NaufalElyzar11/AAC-Pelipat-Pakaian/pratinjau_3d.png

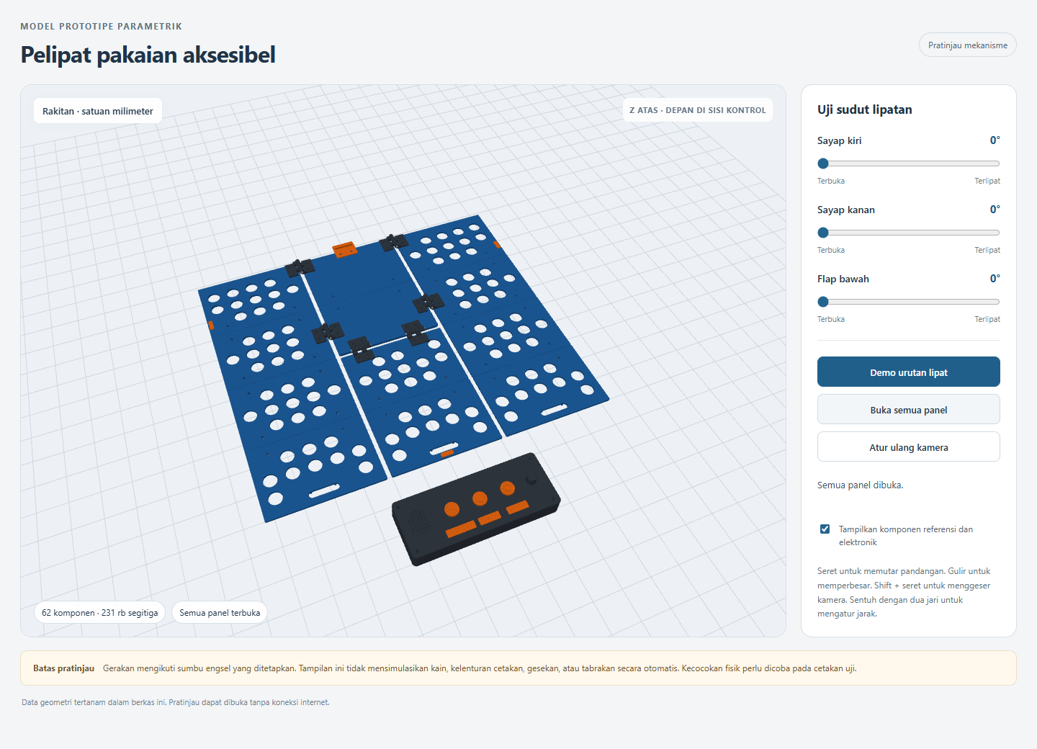
pratinjau_3d.png
