NaufalElyzar11/AAC-Pelipat-Pakaian/step/assembly_open.step

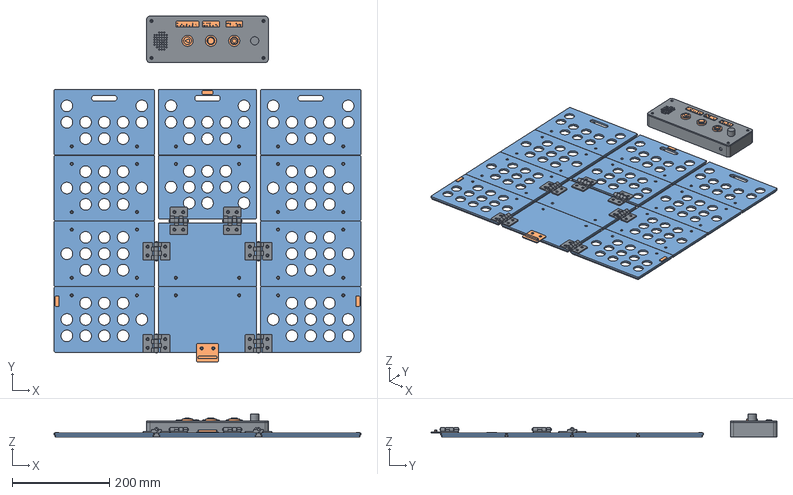
[picture p2: CAD file, 2026-10-27]
step/assembly_open.step
630.0 x 711.0 x 47.2 mm
panel_L1
panel_L2
panel_L3
panel_L4
splice_L_1_1
splice_L_1_2
splice_L_2_1
splice_L_2_2
splice_L_3_1
splice_L_3_2
panel_R1
panel_R2
panel_R3
panel_R4
splice_R_1_1
splice_R_1_2
splice_R_2_1
splice_R_2_2
splice_R_3_1
splice_R_3_2
panel_F1
panel_F2
splice_F_1_1
splice_F_1_2
panel_B1
panel_B2
splice_B_1_1
splice_B_1_2
L1_fixed
L1_moving
L1_pin
L2_fixed
L2_moving
L2_pin
R1_fixed
R1_moving
R1_pin
R2_fixed
R2_moving
R2_pin
B1_fixed
B1_moving
B1_pin
B2_fixed
B2_moving
B2_pin
collar_stop
left_index
right_index
bottom_index
control_base
control_lid
braille_kembali
braille_mulai
braille_ulang
button_reference_1
button_overlay_back
button_reference_2
button_overlay_next
button_reference_3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
