NaufalElyzar11/AAC-Pelipat-Pakaian/step/TEST_pin_bores_42_43_44_45.step

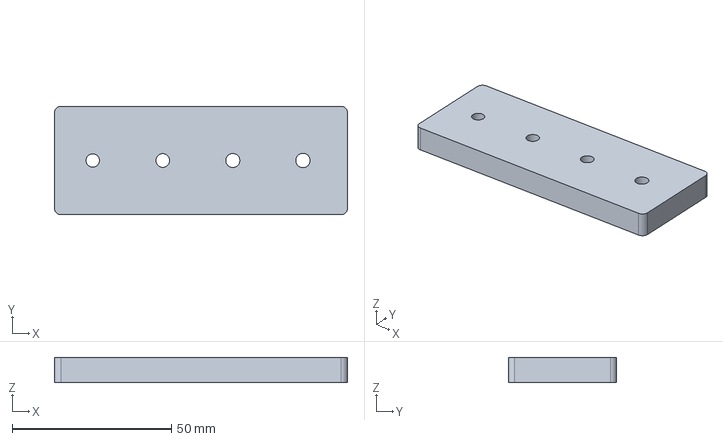
[picture p3: CAD file, 2026-10-27]
step/TEST_pin_bores_42_43_44_45.step
92.0 x 34.0 x 8.00 mm
