NaufalElyzar11/AAC-Pelipat-Pakaian/tests/TEST_hinge_panel_moving.stl

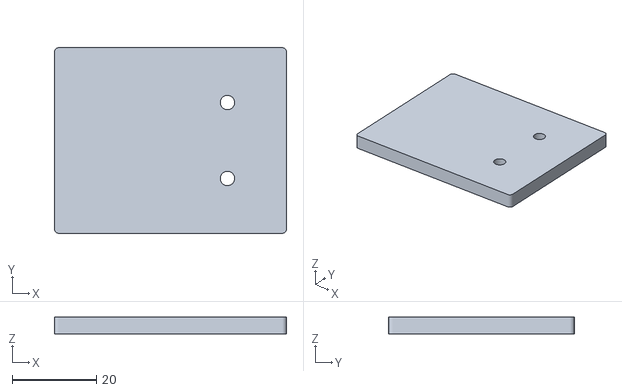
[picture p4: CAD file, 2026-10-27]
tests/TEST_hinge_panel_moving.stl
55.0 x 44.0 x 4.00
