NaufalElyzar11/AAC-Pelipat-Pakaian/step/panel_B1.step

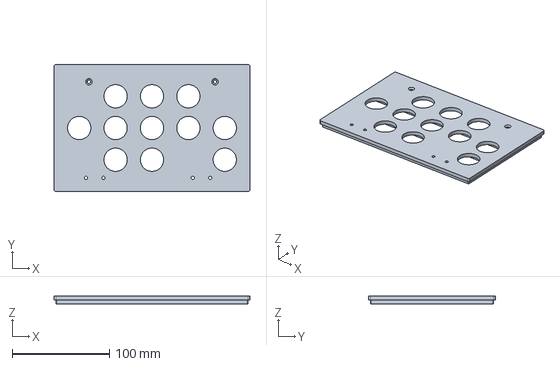
[picture p5: CAD file, 2026-10-27]
step/panel_B1.step
202.0 x 130.8 x 8.00 mm
