NaufalElyzar11/AAC-Pelipat-Pakaian/tests/TEST_splice_panel_A.stl

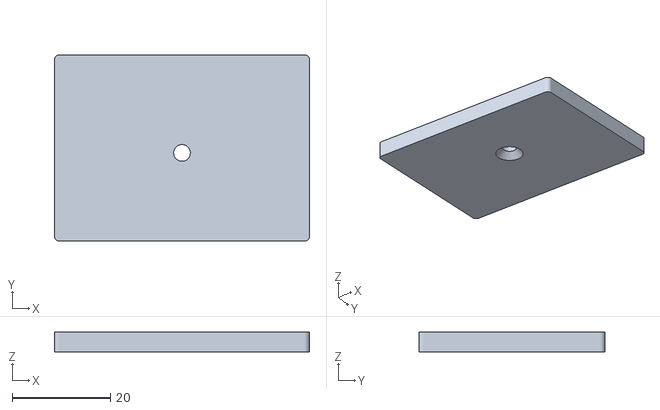
[picture p6: CAD file, 2026-10-27]
tests/TEST_splice_panel_A.stl
52.0 x 38.0 x 4.00
