NaufalElyzar11/AAC-Pelipat-Pakaian/step/splice_strap.step

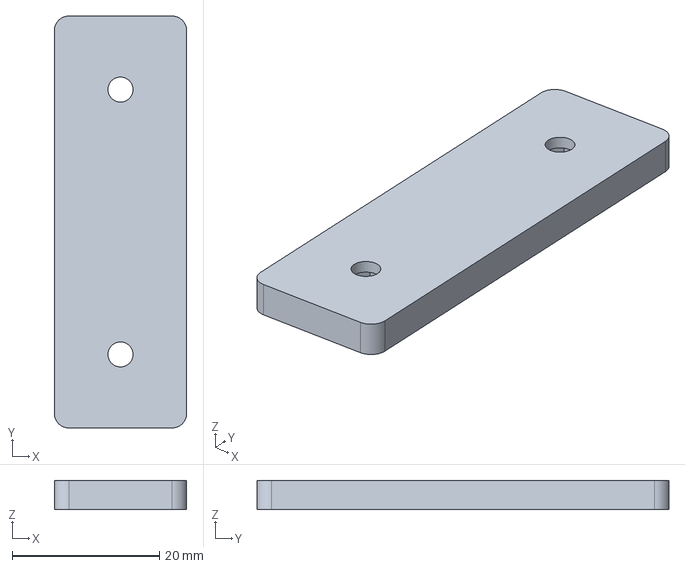
[picture p7: CAD file, 2026-10-27]
step/splice_strap.step
18.0 x 56.0 x 4.00 mm
