NaufalElyzar11/AAC-Pelipat-Pakaian/step/marker_collar.step

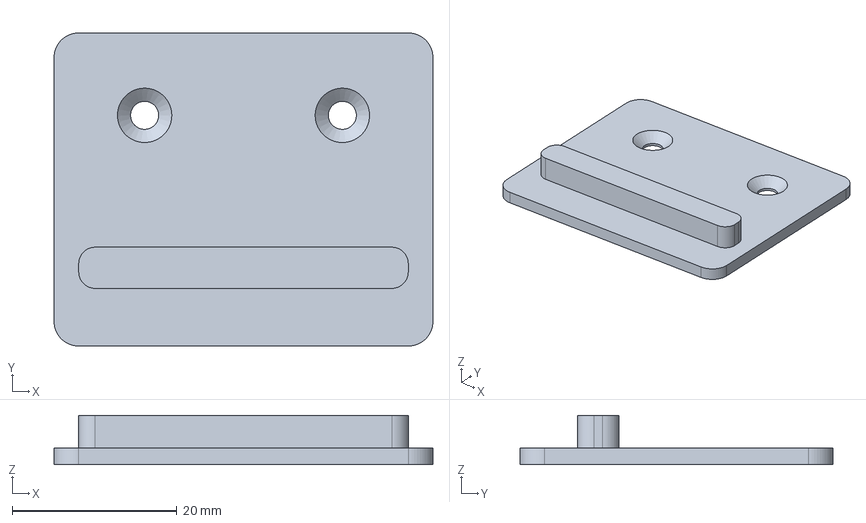
[picture p9: CAD file, 2026-10-27]
step/marker_collar.step
46.0 x 38.0 x 6.00 mm
