NaufalElyzar11/AAC-Pelipat-Pakaian/step/panel_R2.step

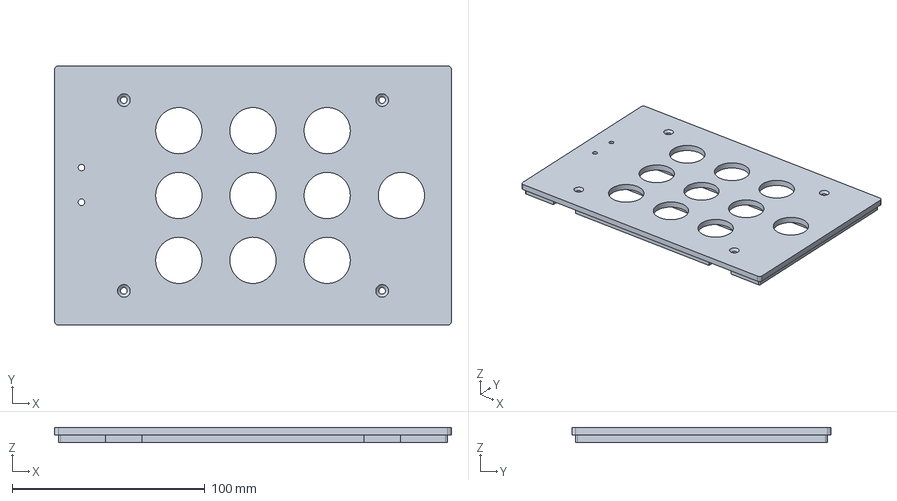
[picture p10: CAD file, 2026-10-27]
step/panel_R2.step
206.0 x 134.6 x 8.00 mm
