NaufalElyzar11/AAC-Pelipat-Pakaian/step/panel_L4.step

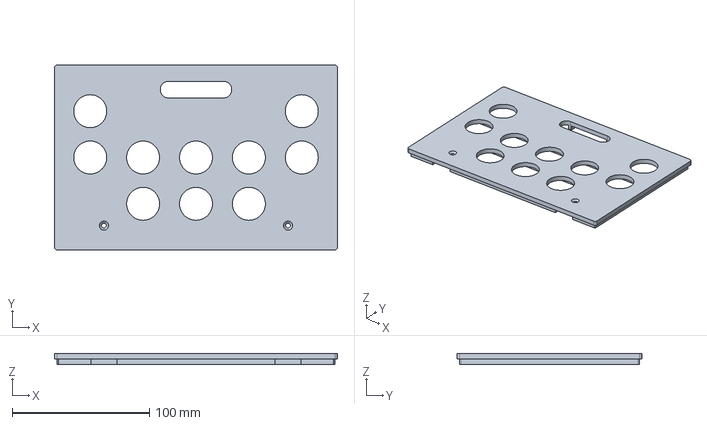
[picture p11: CAD file, 2026-10-27]
step/panel_L4.step
206.0 x 134.8 x 8.00 mm
