NaufalElyzar11/AAC-Pelipat-Pakaian/step/hinge_B.step

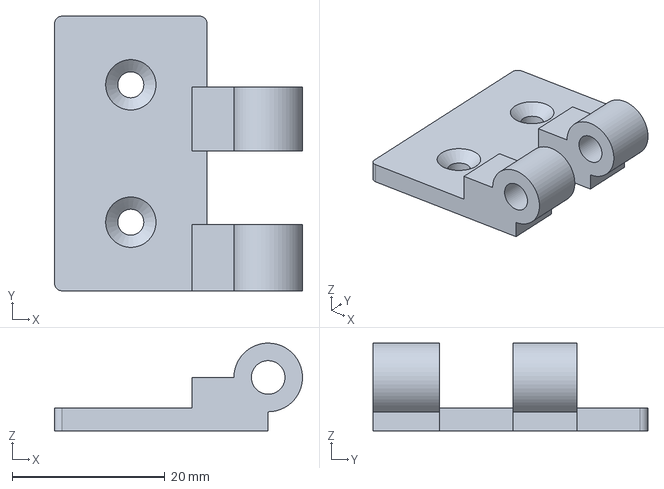
[picture p14: CAD file, 2026-10-27]
step/hinge_B.step
32.5 x 36.0 x 11.5 mm
