NaufalElyzar11/AAC-Pelipat-Pakaian/step/panel_F1.step

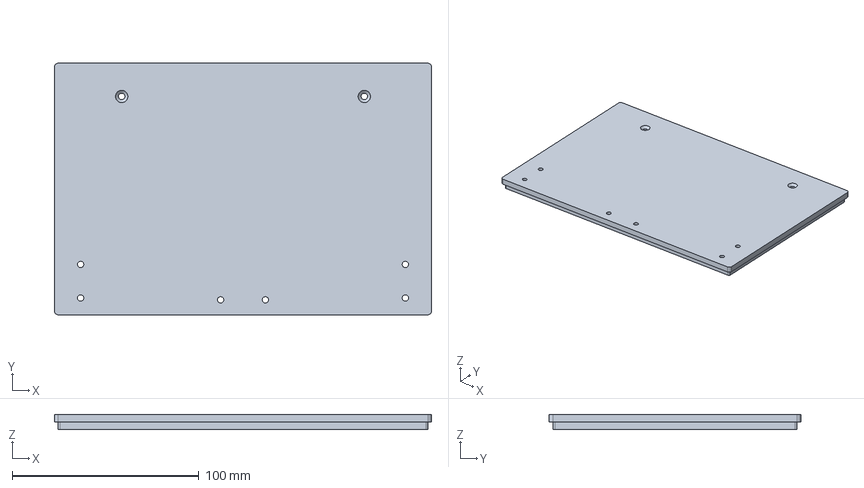
[picture p15: CAD file, 2026-10-27]
step/panel_F1.step
202.0 x 134.8 x 8.00 mm
