NaufalElyzar11/AAC-Pelipat-Pakaian/step/braille_kembali.step

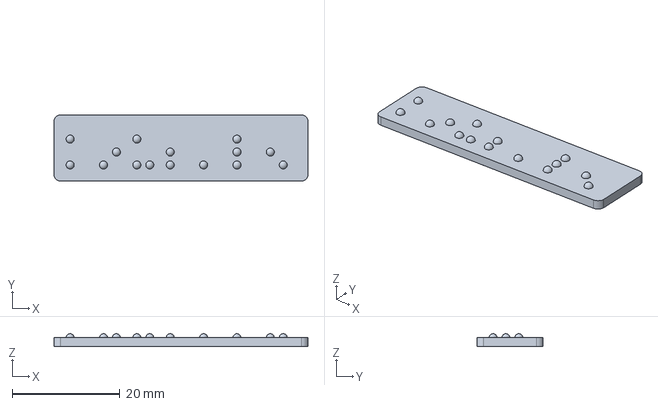
[picture p16: CAD file, 2026-10-27]
step/braille_kembali.step
47.2 x 12.3 x 2.35 mm
