NaufalElyzar11/AAC-Pelipat-Pakaian/step/button_overlay_next.step

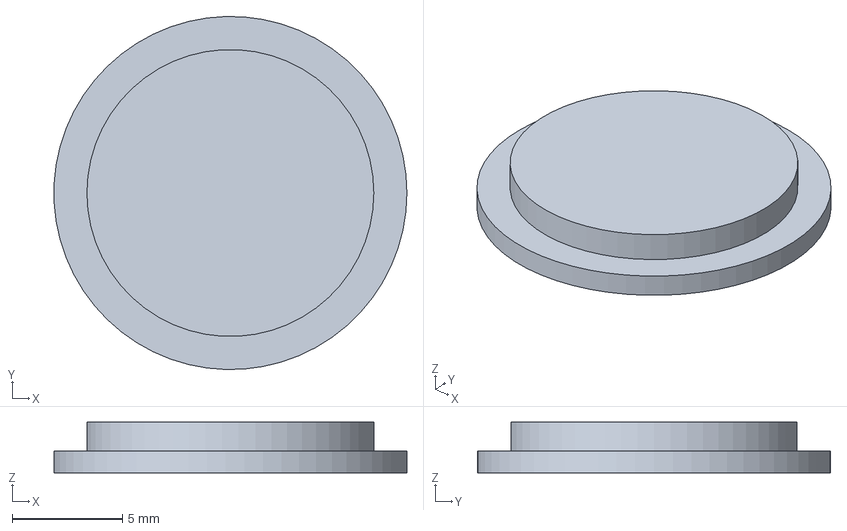
[picture p17: CAD file, 2026-10-27]
step/button_overlay_next.step
16.0 x 16.0 x 2.30 mm
