NaufalElyzar11/AAC-Pelipat-Pakaian/step/OPTION_sensor_adapter_template.step

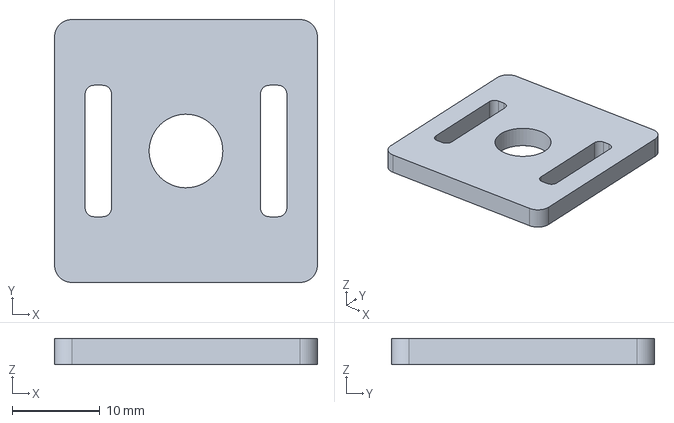
[picture p18: CAD file, 2026-10-27]
step/OPTION_sensor_adapter_template.step
30.0 x 30.0 x 3.00 mm
