NaufalElyzar11/AAC-Pelipat-Pakaian/step/control_lid.step

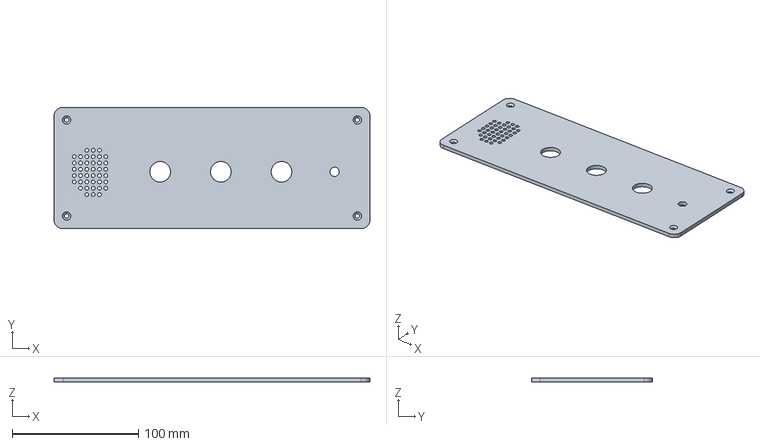
[picture p19: CAD file, 2026-10-27]
step/control_lid.step
250.0 x 96.0 x 3.20 mm
