NaufalElyzar11/AAC-Pelipat-Pakaian/step/braille_ulang.step

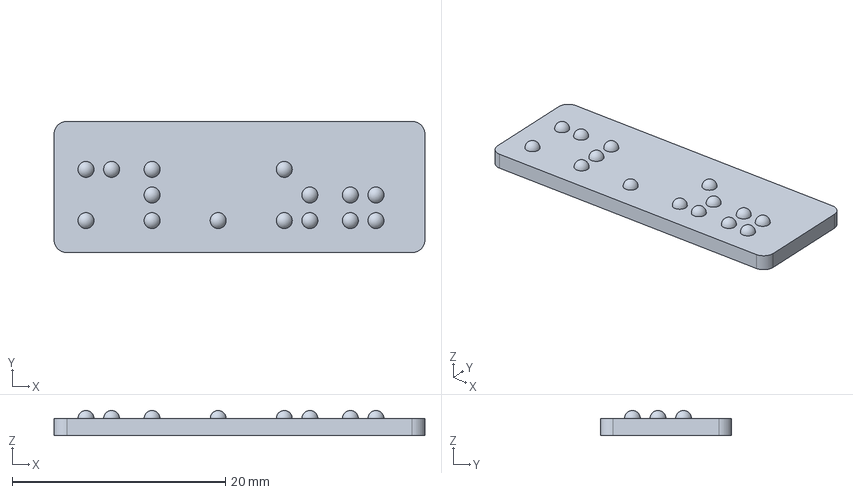
[picture p20: CAD file, 2026-10-27]
step/braille_ulang.step
34.8 x 12.3 x 2.35 mm
