NaufalElyzar11/AAC-Pelipat-Pakaian/step/panel_B2.step

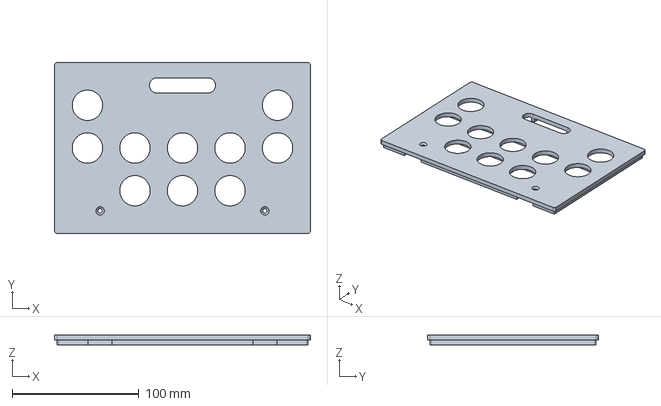
[picture p21: CAD file, 2026-10-27]
step/panel_B2.step
202.0 x 134.8 x 8.00 mm
