NaufalElyzar11/AAC-Pelipat-Pakaian/step/panel_F2.step

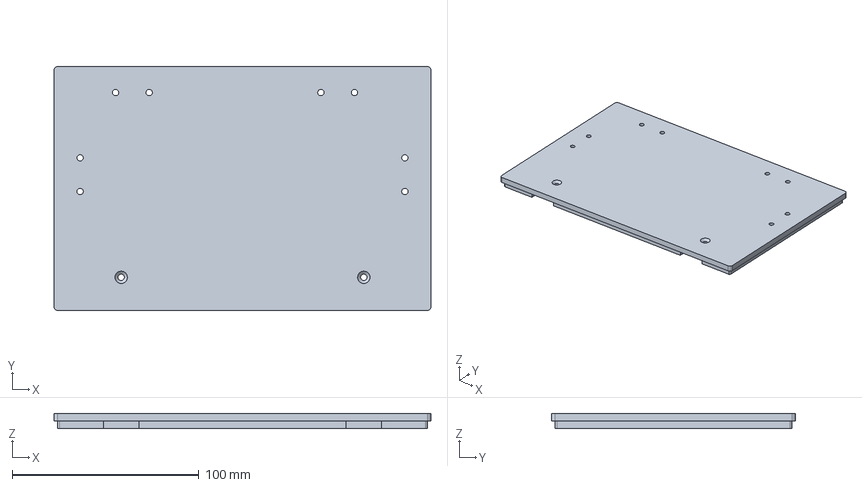
[picture p22: CAD file, 2026-10-27]
step/panel_F2.step
202.0 x 130.8 x 8.00 mm
