NaufalElyzar11/AAC-Pelipat-Pakaian/step/marker_index.step

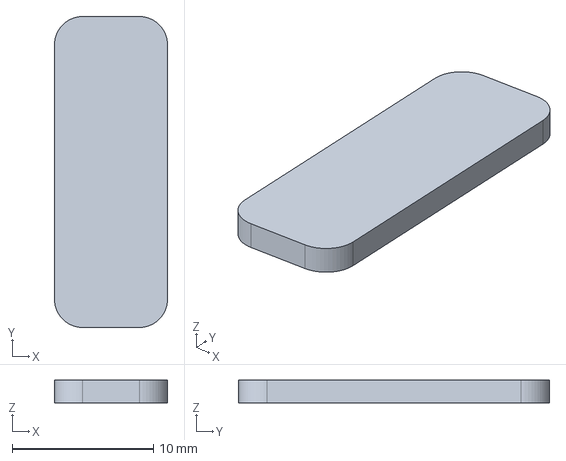
[picture p23: CAD file, 2026-10-27]
step/marker_index.step
8.00 x 22.0 x 1.60 mm
