NaufalElyzar11/AAC-Pelipat-Pakaian/step/control_base.step

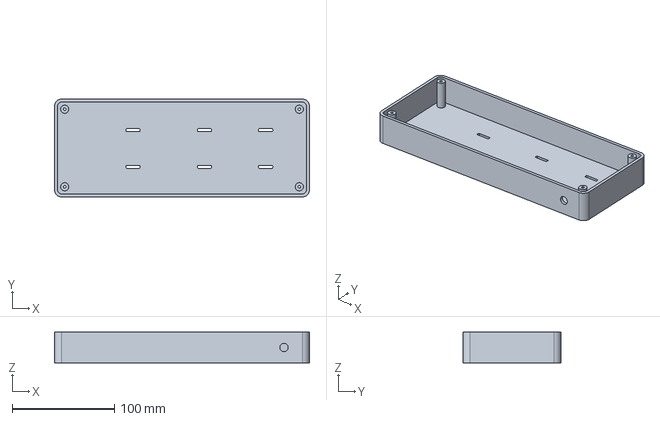
[picture p24: CAD file, 2026-10-27]
step/control_base.step
250.0 x 96.0 x 30.0 mm
