NaufalElyzar11/AAC-Pelipat-Pakaian/(list of files, cad)

Other CAD files:
tests/TEST_pin_bores_42_43_44_45.stl
tests/TEST_splice_panel_B.stl
tests/TEST_hinge_panel_fixed.stl
step/panel_L2.step
step/TEST_hinge_panel_fixed.step
step/TEST_hinge_panel_moving.step
step/hinge_A.step
step/pose_right_90.step
step/panel_R3.step
step/panel_R1.step
step/braille_mulai.step
step/TEST_splice_panel_A.step
step/TEST_splice_panel_B.step
step/panel_R4.step
step/panel_L1.step
step/panel_L3.step
3mf/OPTION_sensor_adapter_template.3mf
3mf/TEST_hinge_panel_fixed.3mf
3mf/TEST_hinge_panel_moving.3mf
3mf/TEST_pin_bores_42_43_44_45.3mf
3mf/TEST_splice_panel_A.3mf
3mf/TEST_splice_panel_B.3mf
3mf/braille_kembali.3mf
3mf/braille_mulai.3mf
3mf/braille_ulang.3mf
3mf/button_overlay_back.3mf
3mf/button_overlay_next.3mf
3mf/button_overlay_repeat.3mf
3mf/control_base.3mf
3mf/control_lid.3mf
3mf/hinge_A.3mf
3mf/hinge_B.3mf
3mf/marker_collar.3mf
3mf/marker_index.3mf
3mf/panel_B1.3mf
3mf/panel_B2.3mf
3mf/panel_F1.3mf
3mf/panel_F2.3mf
3mf/panel_L1.3mf
3mf/panel_L2.3mf
3mf/panel_L3.3mf
3mf/panel_L4.3mf
3mf/panel_R1.3mf
3mf/panel_R2.3mf
3mf/panel_R3.3mf
3mf/panel_R4.3mf
3mf/splice_strap.3mf
stl/OPTION_sensor_adapter_template.stl
stl/braille_kembali.stl
stl/braille_mulai.stl
stl/braille_ulang.stl
stl/button_overlay_back.stl
stl/button_overlay_next.stl
stl/button_overlay_repeat.stl
stl/control_base.stl
stl/control_lid.stl
stl/hinge_A.stl
stl/hinge_B.stl
stl/marker_collar.stl
stl/marker_index.stl
stl/panel_B1.stl
stl/panel_B2.stl
stl/panel_F1.stl
stl/panel_F2.stl
stl/panel_L1.stl
stl/panel_L2.stl
stl/panel_L3.stl
stl/panel_L4.stl
stl/panel_R1.stl
stl/panel_R2.stl
stl/panel_R3.stl
stl/panel_R4.stl
stl/splice_strap.stl
